cudnn/fx3eyes/hardware/XP/BOM/XPCAM 1V1 PCB BOM.xls

电子产品零件表
 |  | 版本:XPCAM 1V1 PCB BOM V1.0
序号 | 物料代码 | 数量 | 元件位置 | 规格 | 用途 | 备注
1 | 4.2.03.0089 | 3 | C16,C17,C18 | 贴片电容 10nF/0402/50V/10% | PCB
2 | 4.2.03.0088 | 14 | C2,C3,C4,C7,C8, C11,C12,C15,C19,C20, C21,C25,C26,C36 | 贴片电容 0.1uF/0402/16V/10% | PCB
3 | 4.2.03.0096 | 7 | C5,C9,C13,C23,C27, C34,C42 | 贴片电容 1uF/0402/6.3V/10% | PCB
4 | 4.2.03.0095 | 4 | C6,C10,C14,C45 | 贴片电容 4.7uF/0402/6.3V/20% | PCB
5 | 4.2.03.0101 | 7 | C1,C24,C28,C31,C35, C43,C44 | 贴片电容 10uF/0805/25V/10% | PCB
6 | 4.2.02.0205 | 1 | R7 | 贴片电阻 0R/0402/1% | PCB
7 | 4.2.02.0220 | 1 | R3 | 贴片电阻 22R/0402/5% | PCB
8 | 4.2.02.0214 | 5 | R1,R2,R4,R5,R6 | 贴片电阻 10K/0402/1% | PCB
9 | 7.2.01.0411 | 3 | U2,U3,U4 | 降压芯片 TPS73533DRVR | PCB
10 | 7.2.01.0412 | 1 | U1 | 集成芯片 MT9V024IA7XTM | PCB
11 | 7.2.07.0382 | 1 | J1 | 接插端子 20525-030E-02 | PCB
12 | 7.2.06.0203 | 1 |  | PCB光板 | PCB
