cudnn/fx3eyes/hardware/XP2/BOM/XPCAM_1V4 PCB BOM.xls

Sheet: Read me
删除R38,C65更改为4.2.03.0095

Sheet: 170504
电子产品零件表
 |  | 版本:XPCAM 1V4 PCB BOM V1.0
序号 | 物料代码 | 数量 | 元件位置 | 元件描述 | 用途 | 备注
1 | 4.2.03.0104 | 1 | C85 | 贴片电容 1nF/0402/50V/10% | PCB
2 | 4.2.03.0089 | 2 | C81,C84 | 贴片电容 10nF/0402/50V/10% | PCB
3 | 4.2.03.0088 | 10 | C46,C47,C48,C61,C62, C66,C77,C78,C82,C83 | 贴片电容 0.1uF/0402/16V/10% | PCB
4 | 4.2.03.0095 | 7 | C44,C52,C63,C65,C70,C76, C79 | 贴片电容 4.7uF/0402/6.3V/20% | PCB
5 | 4.2.03.0101 | 4 | C39,C45,C64,C71 | 贴片电容 10uF/0805/25V/10% | PCB
6 | 4.2.02.0220 | 1 | R24 | 贴片电阻 22R/0402/5% | PCB
7 | 4.2.02.0214 | 5 | R23,R39,R40,R41,R42 | 贴片电阻 10K/0402/1% | PCB
8 | 7.2.04.0005 | 1 | L1 | 贴片电感 10uH/0805/10% | PCB
9 | 7.2.01.0411 | 1 | U5 | 降压芯片 TPS73533DRVR | PCB
10 | 7.2.01.0412 | 1 | U1 | 集成芯片 MT9V024IA7XTM | PCB
11 | 7.2.07.0382 | 1 | J1 | 接插端子 20525-030E-02 | PCB
12 | 7.2.06.0224 | 1 |  | PCB光板 | PCB
