cudnn/fx3eyes/hardware/XP2/BOM/XPIAC_1V3 PCB BOM.xls

Sheet: Read me
更改说明

Sheet: 171017
电子产品零件表
 |  | 版本:XPIAC 1V3 PCB BOM V1.0
料号 | 物料代码 | 数量 | 元件位置 | 元件描述 | 用途 | 备注
1 | 4.2.03.0104 | 1 | C85 | 贴片电容 1nF/0402/50V/10% | PCB
2 | 7.2.03.0153 | 2 | C49,C50 | 贴片电容 12pF/0402/50V/5% | PCB
3 | 4.2.03.0089 | 10 | C13,C16,C17,C22,C27, C81,C94,C95,C97,C98 | 贴片电容 10nF/0402/50V/10% | PCB
4 | 4.2.03.0088 | 40 | C1,C3,C4,C5,C6,C7, C8,C9,C10,C11,C12, C14,C15,C19,C21,C23, C24,C26,C29,C31,C33, C35,C37,C40,C41,C42, C46,C48,C51,C53,C58, C59,C61,C66,C68,C69, C77,C78,C82,C86 | 贴片电容 0.1uF/0402/16V/10% | PCB
5 | 7.2.03.0146 | 1 | C57 | 贴片电容 0.47uF/0402/6.3V/10% | PCB
6 | 4.2.03.0095 | 13 | C25,C28,C36,C44,C52, C54,C55,C56,C60,C63, C70,C76,C79 | 贴片电容 4.7uF/0402/6.3V/20% | PCB
7 | 4.2.03.0101 | 6 | C32,C34,C39,C43,C45, C64 | 贴片电容 10uF/0805/25V/10% | PCB
8 | 4.2.03.0094 | 4 | C2,C18,C20,C30 | 贴片电容 47uF/0805/6.3V/20% | PCB
9 | 7.2.04.0086 | 1 | L2 | 贴片电感 100uH/600mA | PCB
10 | 7.2.04.0005 | 1 | L1 | 贴片电感 10uH/0805 | PCB
11 | 4.2.02.0205 | 2 | R30,R57 | 贴片电阻 0R/0402/1% | PCB
12 | 4.2.02.0220 | 4 | R22,R24,R27,R60 | 贴片电阻 22R/0402/5% | PCB
13 | 4.2.02.0208 | 2 | R6,R21 | 贴片电阻 200R/0402/1% | PCB
14 | 4.2.02.0218 | 7 | R5,R14,R58,R59,R62, R63,R67 | 贴片电阻 1K/0402/1% | PCB
15 | 4.2.02.0209 | 1 | R18 | 贴片电阻 1.5K/0402/1% | PCB
16 | 4.2.02.0226 | 2 | R25,R26 | 贴片电阻 2.0K/0402/5% | PCB
17 | 4.2.02.0210 | 1 | R20 | 贴片电阻 6.04K/0402/1% | PCB
18 | 4.2.02.0217 | 12 | R1,R2,R3,R11,R12, R15,R16,R17,R19,R29, R31,R32 | 贴片电阻 4.7K/0402/1% | PCB
19 | 4.2.02.0214 | 7 | R9,R23,R39,R40,R41, R42,R44 | 贴片电阻 10K/0402/1% | PCB
20 | 4.2.02.0213 | 1 | R53 | 贴片电阻 28K/0402/1% | PCB
21 | 4.2.02.0233 | 3 | R4,R13,R56 | 贴片电阻 100K/0402/1% | PCB
22 | 7.2.05.0130 | 1 | LED1 | 发光二极管 红色/0805 | PCB
23 | 4.2.04.0507 | 3 | FB1,FB2,FB3 | 磁珠 600@100MHz | PCB
24 | 7.2.08.0222 | 1 | Y2 | 27M晶振 XTAL-3225 | PCB
25 | 7.2.08.0223 | 1 | U7 | 32.768K晶振 XTAL-3225 | PCB
26 | 7.2.08.0224 | 1 | Y1 | 19.2M晶振 XTAL_3225 | PCB
27 | 7.2.01.0413 | 1 | U9 | 陀螺仪芯片 ICM-20608-G | PCB
28 | 7.2.01.0414 | 1 | U13 | 降压芯片 AS1364-BTDT-AD | PCB
29 | 7.2.05.1005 | 4 | Q1,Q2,Q3,Q4 | NPN三极管 BC817 | PCB
30 | 7.2.08.0139 | 2 | S1,S2 | 贴片按键 2P | PCB
31 | 7.2.08.0049 | 1 | U6 | 贴片保险丝 SP3010-04UTG | PCB
32 | 7.2.01.0415 | 1 | U4 | 降压芯片 TPS74801DRCR | PCB
33 | 7.2.01.0416 | 1 | U2 | EEPROM芯片 M25P40-VMN3TPB | PCB
34 | 7.2.01.0417 | 1 | U1 | USB控制器 CYUSB3014 | PCB
35 | 7.2.07.1076 | 1 | J1 | USB3.0插头USB3_MICROB | PCB
36 | 7.2.07.0192 | 1 | P1 | uart接插端子 A1252MV-04P | PCB
37 | 7.2.07.0382 | 1 | J6 | 接插端子 20525-030E-02C | PCB
38 | 7.2.01.0411 | 1 | U5 | 降压芯片 TPS73533DRVR | PCB
39 | 7.2.01.0412 | 1 | U8 | 集成芯片 MT9V024IA7XTM | PCB
40 | 7.2.06.0236 | 1 |  | PCB光板 | PCB
