cudnn/fx3eyes/hardware/XP/schematic&PCB PDF/schematic/XPIMU_1V1_SCH.pdf

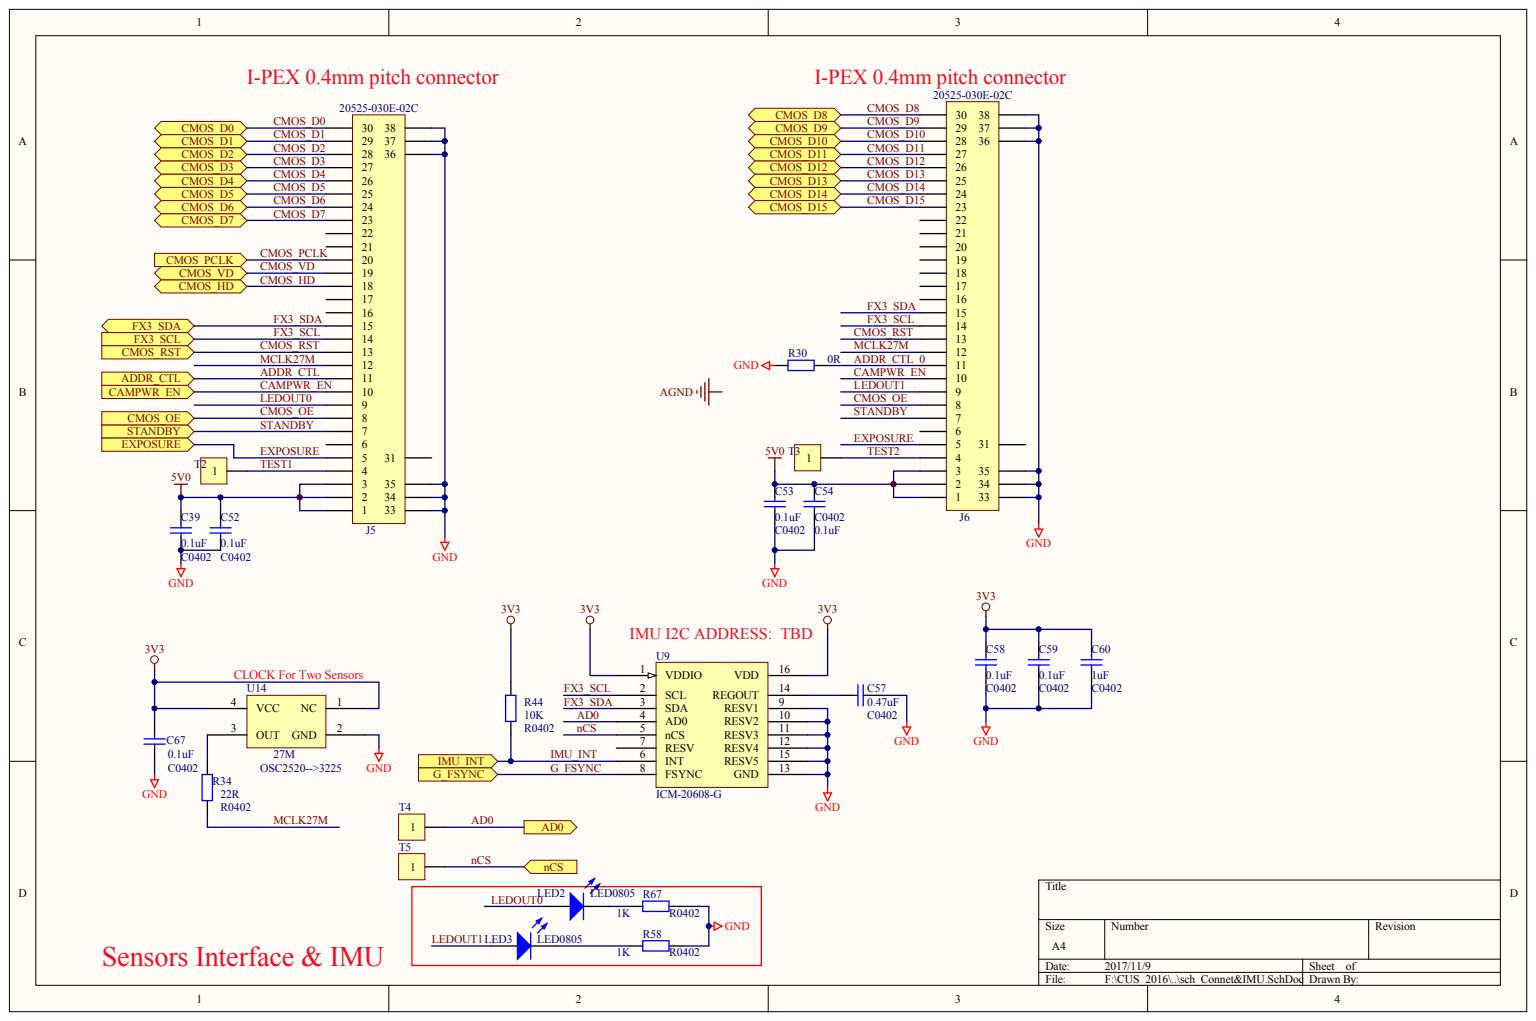
[picture p1: page 1]

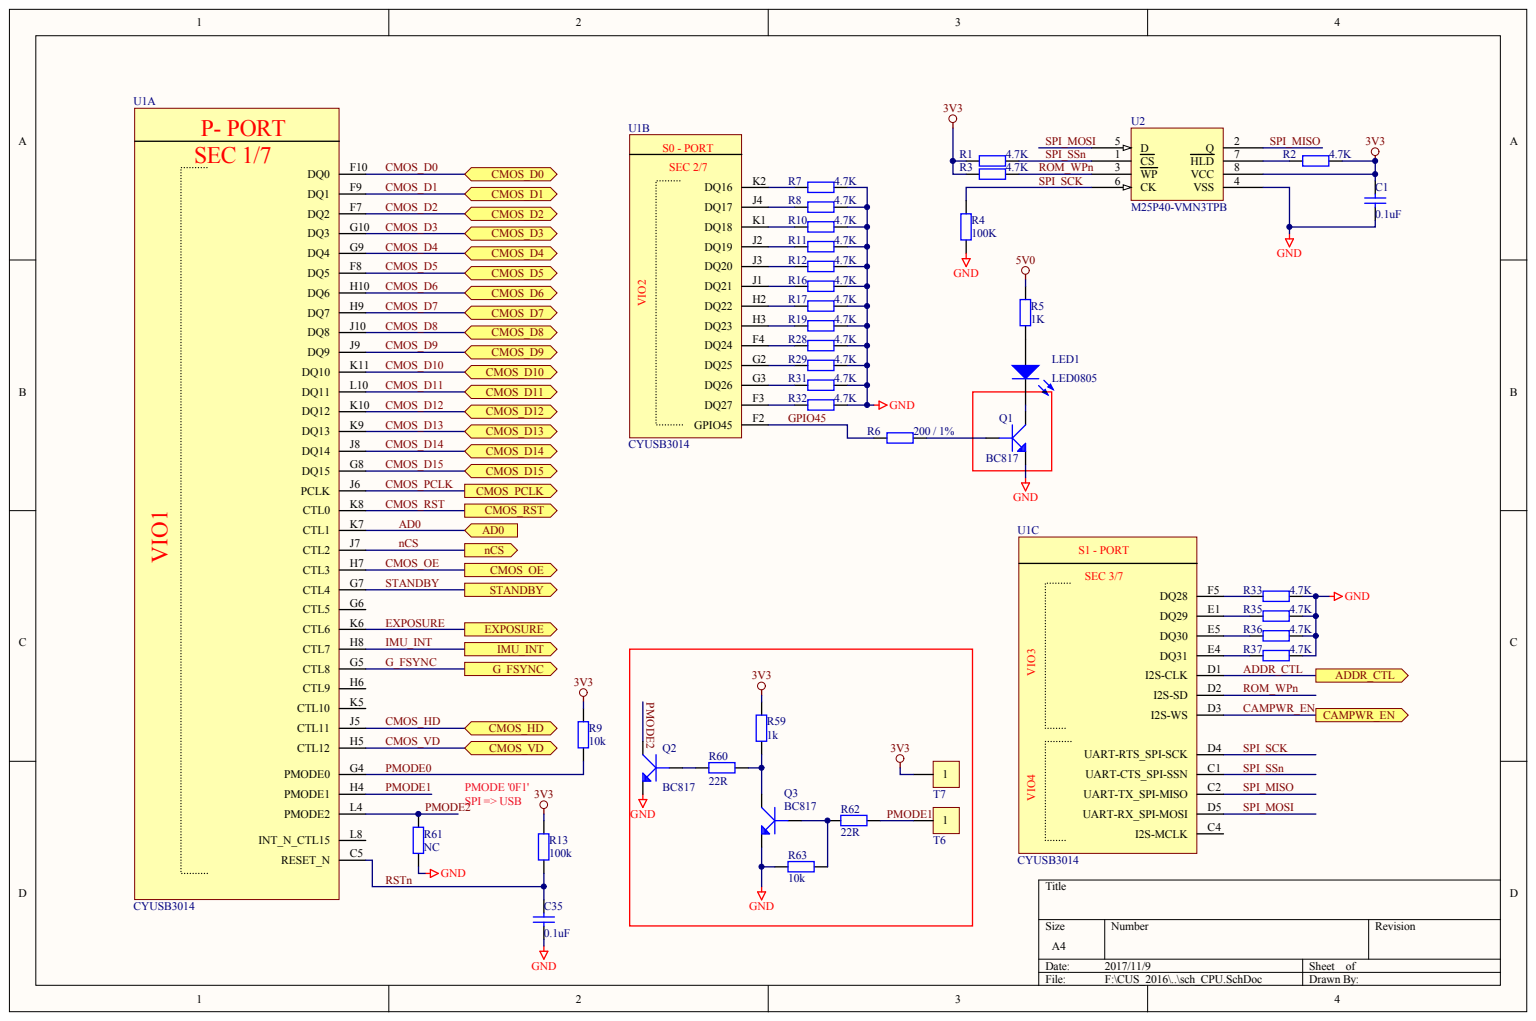
[picture p2: page 2]

SEC 2/ | 7

R3 | 4.7 K ROM _WPn 3

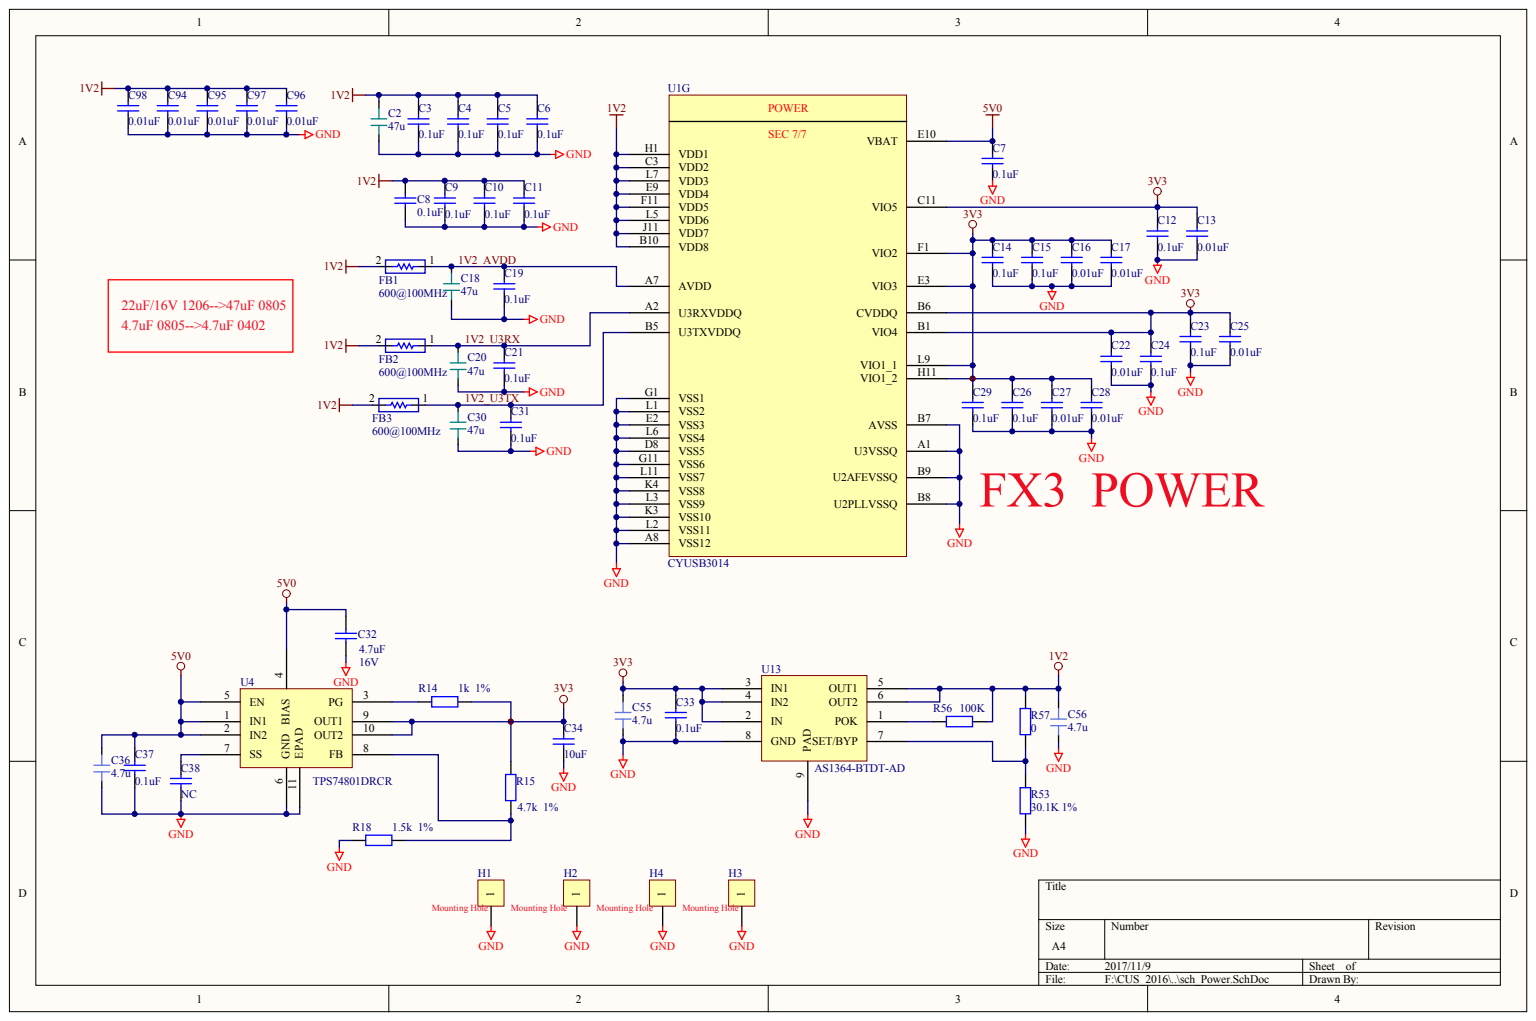
[picture p3: page 3]

VDD3 L7

VDD5 F11
VDD6 L5
VDD7 J11

U3RXVDDQ A2
U3TXVDDQ B5

VSS2 L1
VSS3 E2
VSS4 L6
VSS5 D8
VSS6 G11
VSS7 L11
VSS8 K4
VSS9 L3
VSS10 K3
VSS11 L2

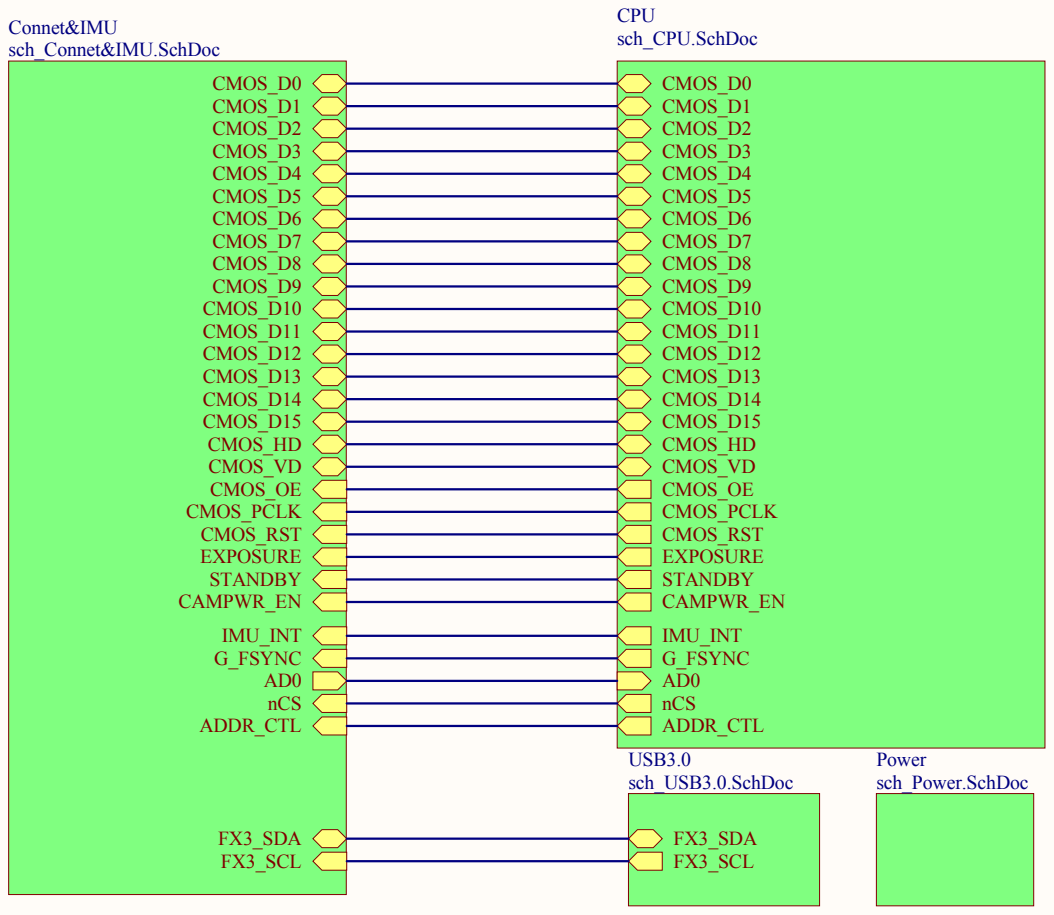
[picture p4: page 4]

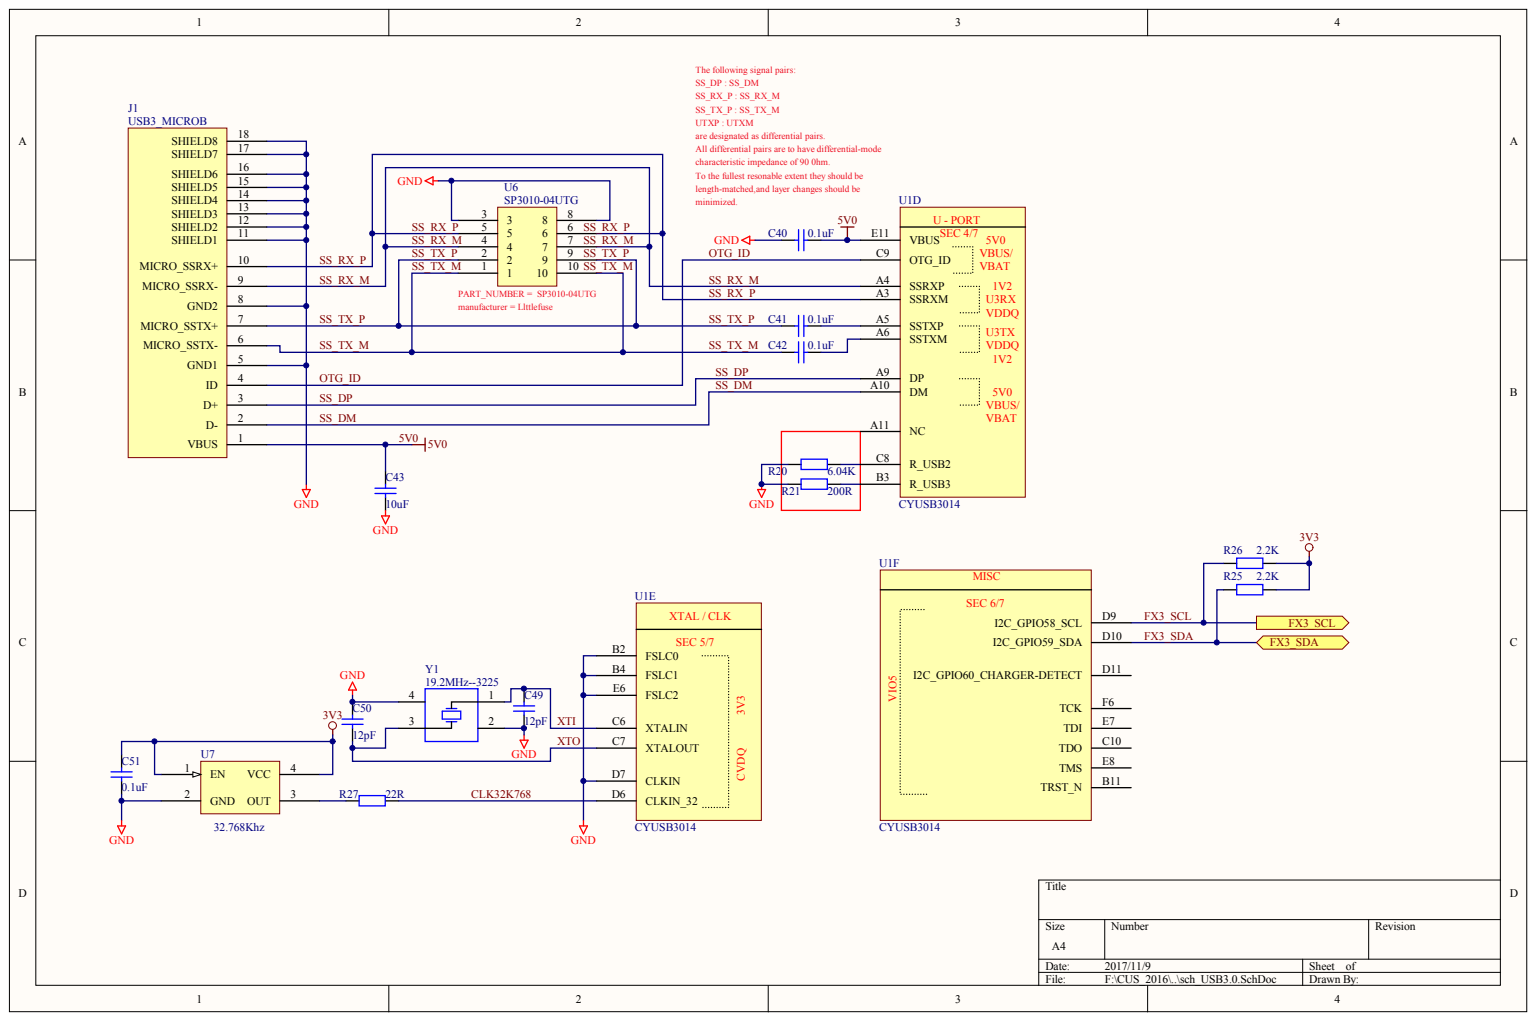
[picture p5: page 5]

The following signal pairs:
UTXP : UTXM
are designated as differential pairs.
All differential pairs are to have differential-mode
characteristic impedance of 90 0hm.
To the fullest resonable extent they should be
length-matched,and layer changes should be
minimized.

SS_RX_M | 4 4 | SS_RX_M
SS_TX_P | 1 1 2 2 | SS_TX_P
SS_TX_M | SS_TX_M | SS_RX_M | SSRXM A3 SSRXP A4

SS_DP | | NC A11
SS_DM

R_USB2 C8

R20 | 6.04K | R_USB3 B3

SEC 6/7

FSLC1 B4
FSLC2 E6

XTALIN C6

12pF | | XTALOUT C7

GND

CLKIN_32 D6

Comment | Description | Designator | Footprint | LibRef | Quantity
0.1uF | Capacitor | C1, C3, C4, C5, C6, C7, C8, C9, C10, C11, C12, C14, C15, C19, C21, C23, C24, C26, C29, C31, C33, C35, C37, C39, C40, C41, C42, C51, C52, C53, C54, C58, C59, C67 | 0402C | Cap | 34
47u | CC08052B476M5B 20D | C2, C18, C20, C30 | 0805C | cap0805 | 4
0.01uF | Capacitor | C13, C16, C17, C22, C25, C27, C28, C94, C95, C96, C97, C98 | 0402C | Cap | 12
4.7uF | Capacitor | C32 | 0805C | Cap | 1
10uF | Capacitor | C34, C43 | 0805C | Cap | 2
4.7u | CC0402MRX5R5BB 475 | C36, C55, C56 | 0402C | cap0402 | 3
NC | Capacitor | C38 | 0402C | Cap | 1
12pF | Capacitor | C49, C50 | 0402C | Cap | 2
0.47uF | Capacitor | C57 | 0402C | Cap | 1
1uF | Capacitor | C60 | 0402C | Cap | 1
600@100MHz | | FB1, FB2, FB3 | 0402R | 600@100MHz | 3
CON1 | Connector | H1, H2, H3, H4 | PAD_M3_D350_45 0 | CON1 | 4
USB3_MICROB | | J1 | USB3_BA_P65L13 0W51H28 | USB3_MICROB | 1
20525-030E-02C | | J5, J6 | HSA30_P40L196W 42H10_20525 | 20525-030E-02C | 2
LED0805 | 发光二级管 | LED1, LED2, LED3 | LED0805A_L210W 100H60 | LED | 3
BC817 | NPN Transistor | Q1, Q2, Q3 | SOT-23L | NPN | 3
4.7K | Resistor | R1, R2, R3, R7, R8, R10, R11, R12, R16, R17, R19, R28, R29, R31, R32, R33, R35, R36, R37 | 0402R | Resistor | 19
100K | Resistor | R4, R13, R56 | 0402R | Resistor | 3
1K | Resistor | R5, R14, R58, R59, R67 | 0402R | Res2, Resistor | 5
200R | Resistor | R6, R21 | 0402R | Resistor | 2
10K | Resistor | R9, R44, R63 | 0402R | Res2, Resistor | 3
51K | Resistor | R15 | 0402R | Resistor | 1
1.15K | Resistor | R18 | 0402R | Resistor | 1
6.04K | Resistor | R20 | 0402R | Resistor | 1
2.2K | Resistor | R25, R26 | 0402R | Resistor | 2
22R | Resistor | R27, R34, R60, R62 | 0402R | Res2, Resistor | 4
0R | Resistor | R30, R57 | 0402R | Res2, Resistor | 2
30.1K | Resistor | R53 | 0402R | Resistor | 1
NC | Resistor | R61 | 0805R | Resistor | 1
CON1 | Connector | T2, T3, T4, T5, T6, T7 | PAD_TP_D1.2 | CON1 | 6
CYUSB3014 | | U1 | FBGA121_P80L100 W100H11 | CYUSB3014 | 1
M25P40-VMN3TPB | | U2 | SO8N_P127L50W4 0W62H17 | M25P40-VMN3TPB | 1
TPS74801DRCR | | U4 | SON10_P50L32W3 2H10_DRC | TPS74801DRCR | 1
SP3010-04UTG | | U6 | UDFN10_SON_P50 L25W10H55 | SP3010-04UTG | 1
XTAL-3225 | | U7 | XTAL_3225 | XTAL. | 1
ICM-20608-G | | U9 | LGA16_P50L30W3 0H08 | ICM-20608-G | 1
AS1364-BTDT-AD | | U13 | TDFN8_P65L30W3 0H08 | AS1364-BTDT-AD | 1
OSC2520-->3225 | Simple Package Xtal Oscillator | U14 | XTAL_3225 | XTAL-SPXO | 1
19.2MHz--3225 | Crystal Oscillator | Y1 | XTAL_3225 | XTAL | 1
