cudnn/fx3eyes/hardware/XP/schematic&PCB PDF/PCB/XPCAM_1V1..pdf

# H1H¹x1

# H3H³x1

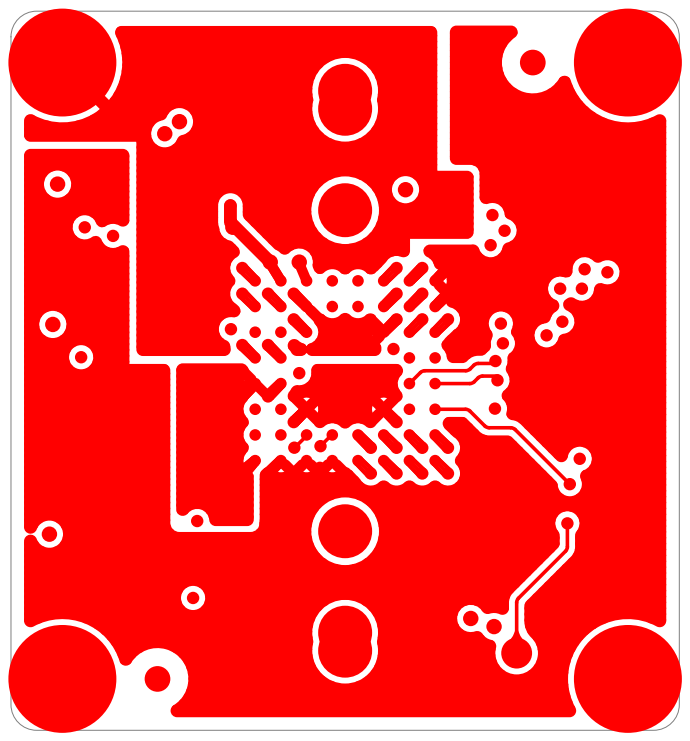
[picture p14: page 1]
U1U¹xA¹ U¹xA² U¹xA³ U¹xA⁴ U¹xA⁵ U¹xA⁶ U¹xA⁷ U¹xA⁸; U¹xB¹ U¹xB² U¹xB³ U¹xB⁴ U¹xB⁵ U¹xB⁶ U¹xB⁷ U¹xB⁸; U¹xC¹ U¹xC² U¹xC³ U¹xC⁶ U¹xC⁷ U¹xC⁸; U¹xD¹ U¹xD² U¹xD⁷ U¹xD⁸; U¹xE¹ U¹xE² U¹xE⁷ U¹xE⁸; U¹xF1 U¹xF2 U¹xF3 U¹xF6 U¹xF7 U¹xF8; U¹xG¹ U¹xG² U¹xG³ U¹xG⁴ U¹xG⁵ U¹xG⁶ U¹xG⁷ U¹xG⁸; U¹xH¹ U¹xH² U¹xH³ U¹xH⁴ U¹xH⁵ U¹xH⁶ U¹xH⁷ U¹xH⁸; H2H²x1; H4H⁴x1; LM1LM¹x1; LM2LM²x1; M1M¹x1; M2M²x1; LM3LM³x1; LM4LM⁴x1

# H1H¹x1

# H3H³x1

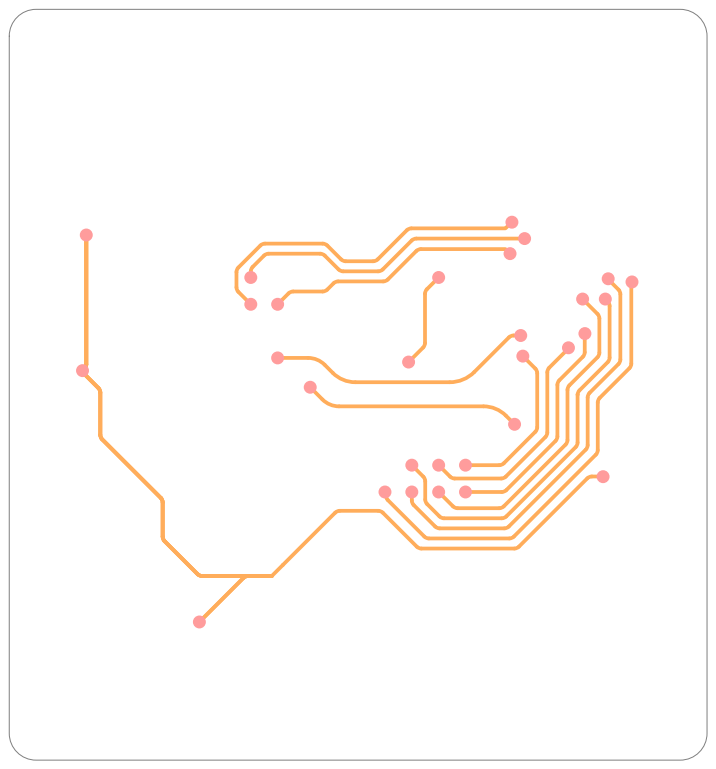
[picture p15: page 2]
H2H²x1; H4H⁴x1; LM1LM¹x1; LM2LM²x1; LM3LM³x1; LM4LM⁴x1

# H1H¹x1

# H3H³x1

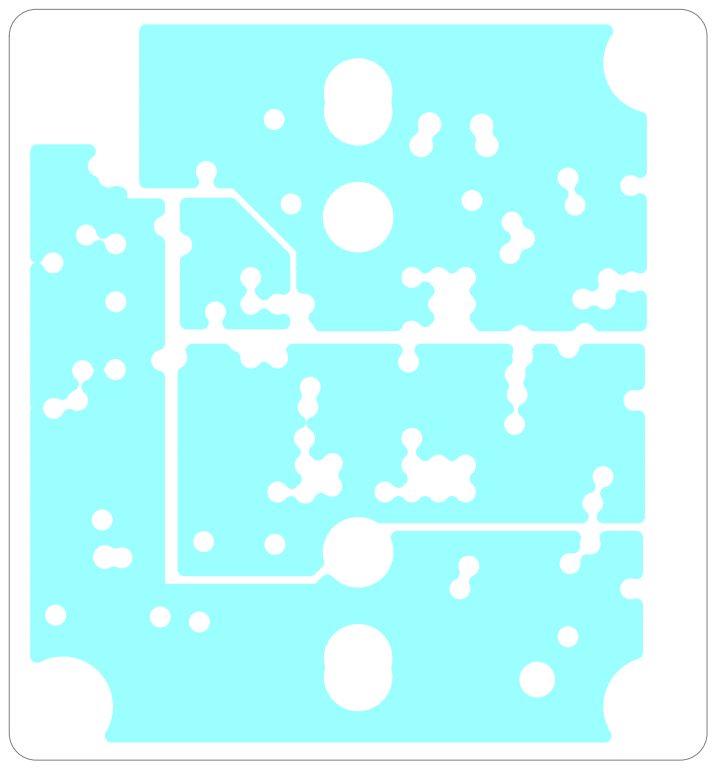
[picture p16: page 3]
H2H²x1; H4H⁴x1; LM1LM¹x1; LM2LM²x1; LM3LM³x1; LM4LM⁴x1

# C28 C²⁸x2 C²⁸x1

# H1H¹x1

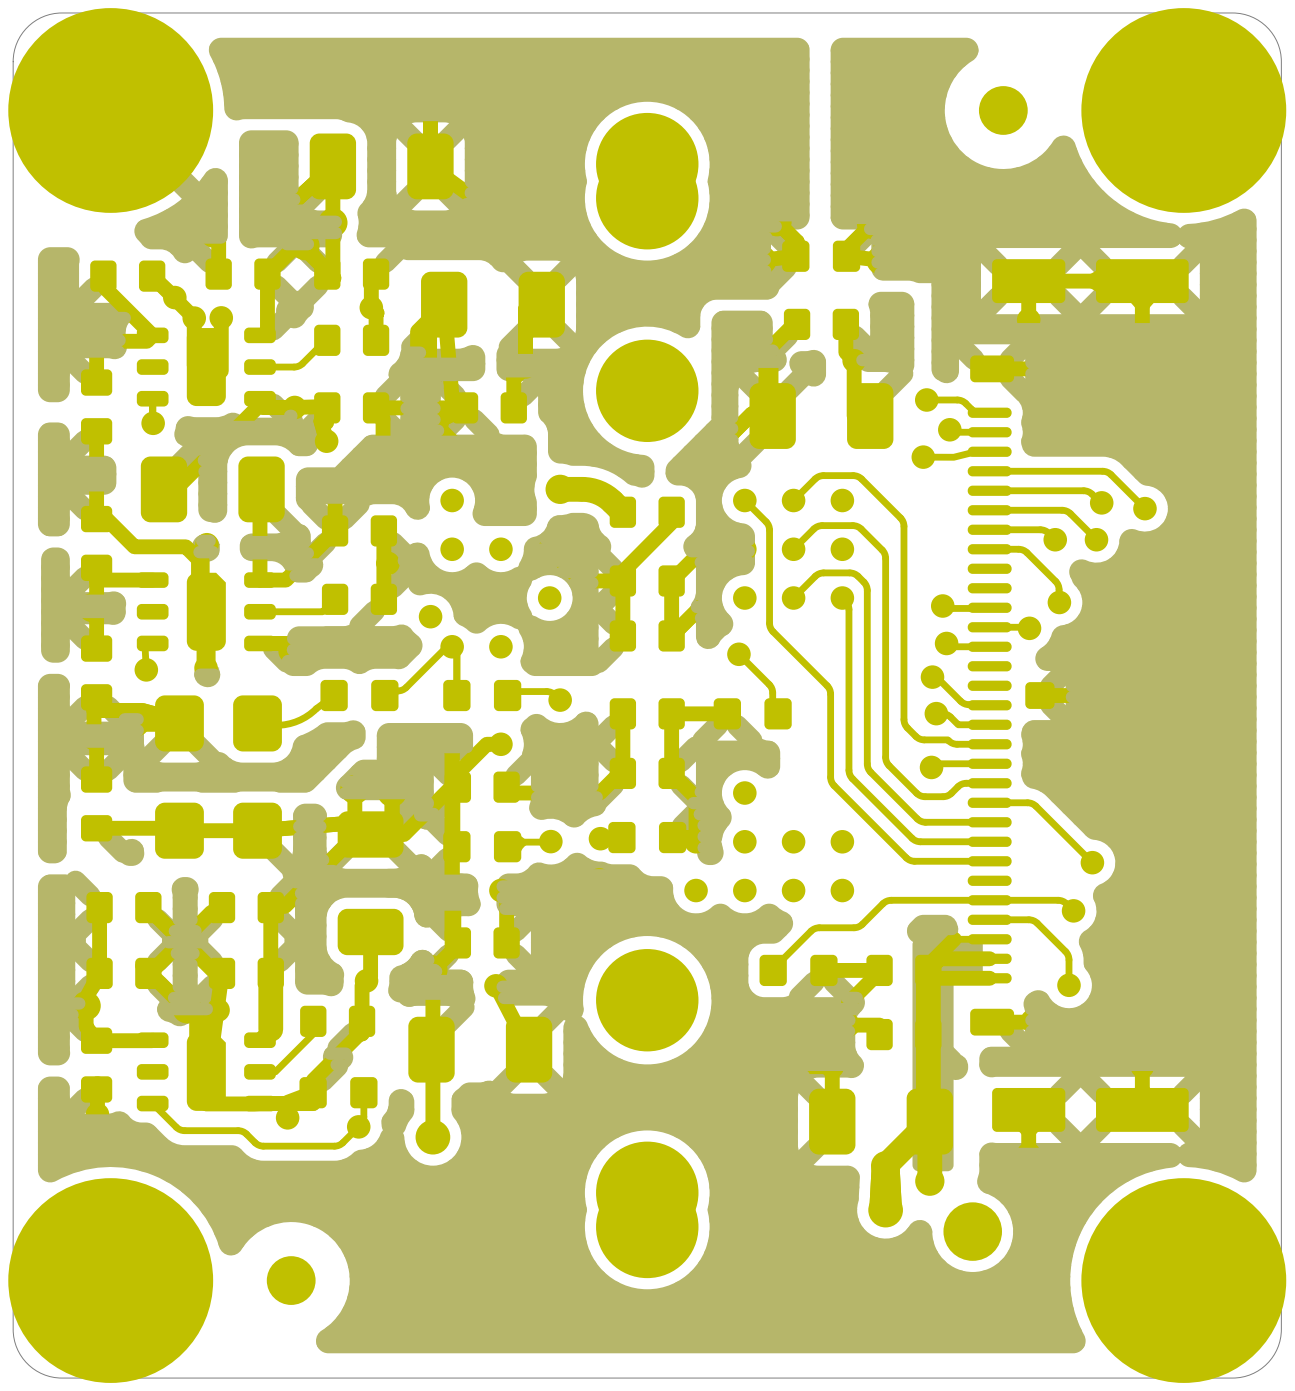
[picture p17: page 4]

# H1H¹x1

# H3H³x1

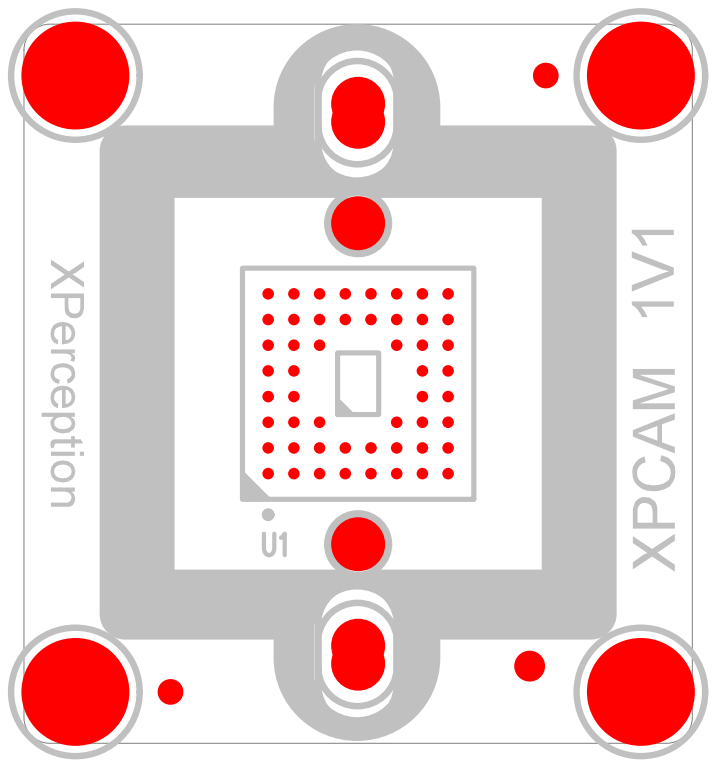
[picture p18: page 5]
XPCAM 1V1; XPerception; H2H²x1; H4H⁴x1; LM1LM¹x1; LM2LM²x1; M1M¹x1; M2M²x1; LM3LM³x1; LM4LM⁴x1

U1U¹xA¹ U¹xA² U¹xA³ U¹xA⁴ U¹xA⁵ U¹xA⁶ U¹xA⁷ U¹xA⁸

C28

J1

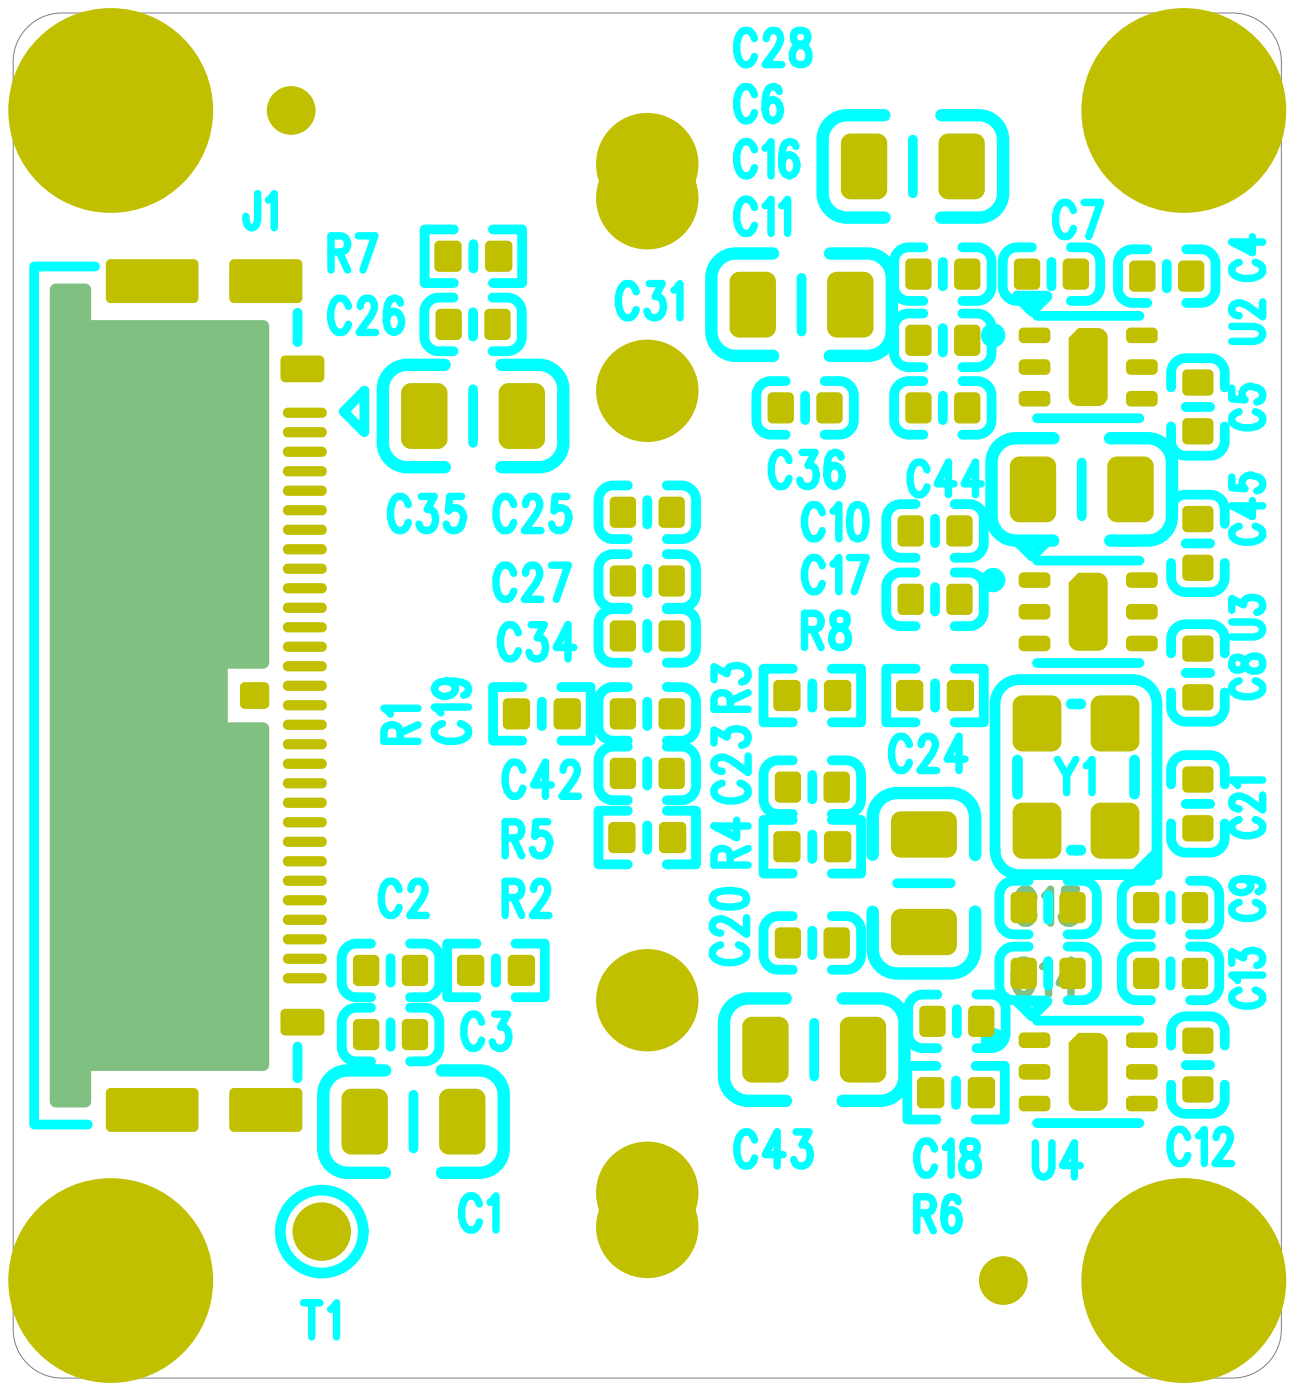
[picture p19: page 6]
