cudnn/fx3eyes/hardware/XP2/schematic&PCB PDF/PCB/XPCAM_1V4.pdf

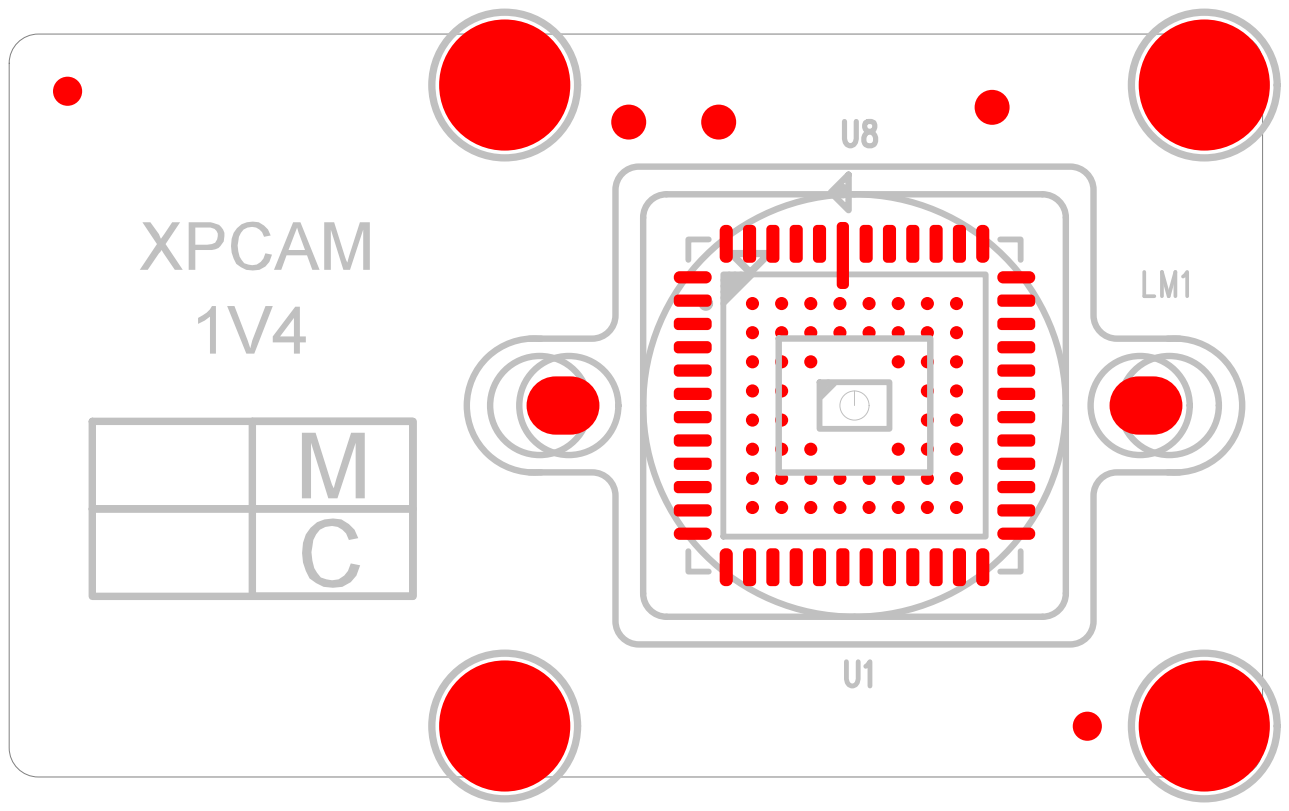
[picture p20: page 1]
XPCAM; LM1 LM1 U8U1 LM¹x1; LM¹x2 U¹xA¹; U¹xA²; U¹xA³; U¹xA⁴; U¹xA⁵; U¹xA⁶; U¹xA⁷; U¹xA⁸ U¹xB¹; U¹xB²; U¹xB³; U¹xB⁴; U¹xB⁵; U¹xB⁶; U¹xB⁷; U¹xB⁸ U¹xC¹; U¹xC²; U¹xC³; U¹xC⁶; U¹xC⁷; U¹xC⁸ U¹xD¹; U¹xD²; U¹xD⁷; U¹xD⁸ U¹xE¹; U¹xE²; U¹xE⁷; U¹xE⁸ U¹xF1; U¹xF2; U¹xF3; U¹xF6; U¹xF7; U¹xF8 U¹xG¹; U¹xG²; U¹xG³; U¹xG⁴; U¹xG⁵; U¹xG⁶; U¹xG⁷; U¹xG⁸ U¹xH¹; U¹xH²; U¹xH³; U¹xH⁴; U¹xH⁵; U¹xH⁶; U¹xH⁷; U¹xH⁸; H1H¹x1; H2H²x1; H3H³x1; H4H⁴x1; M1M¹x1; M2M²x1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

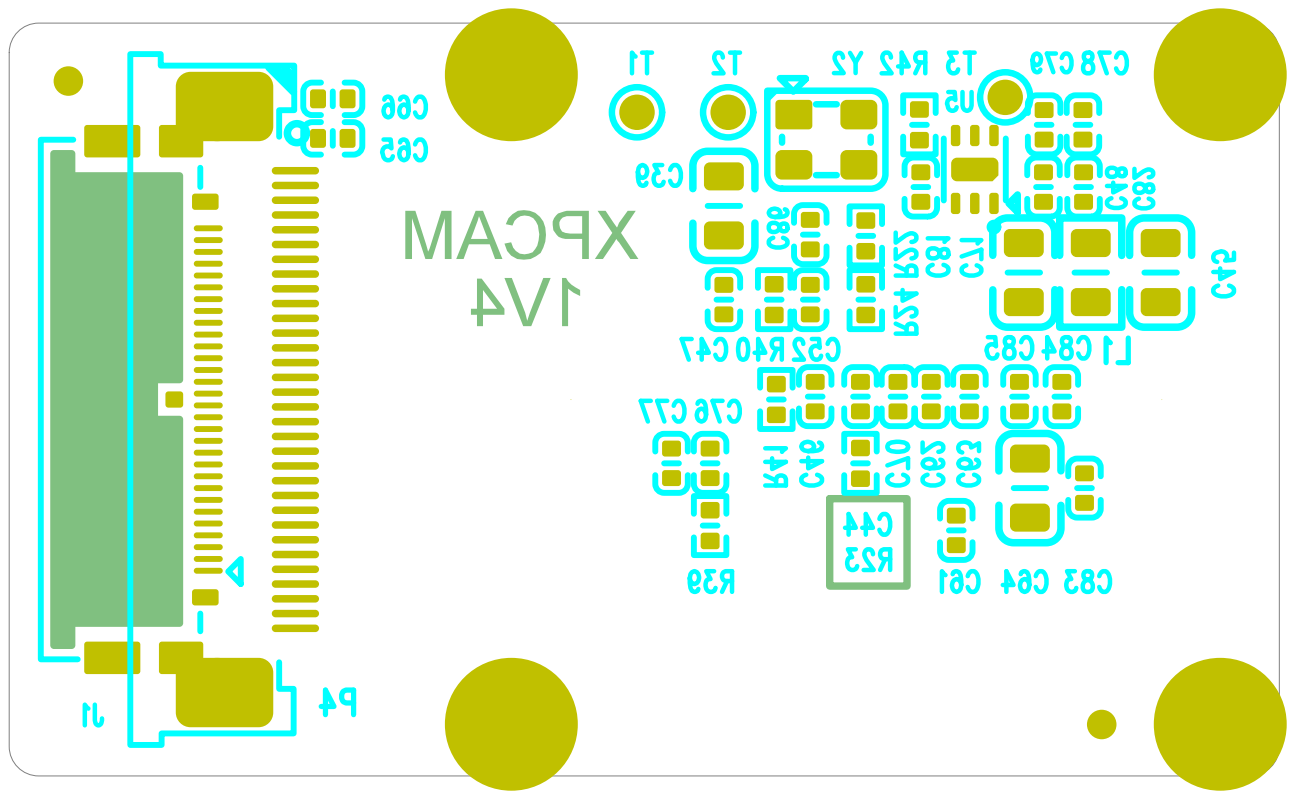
[picture p21: page 2]

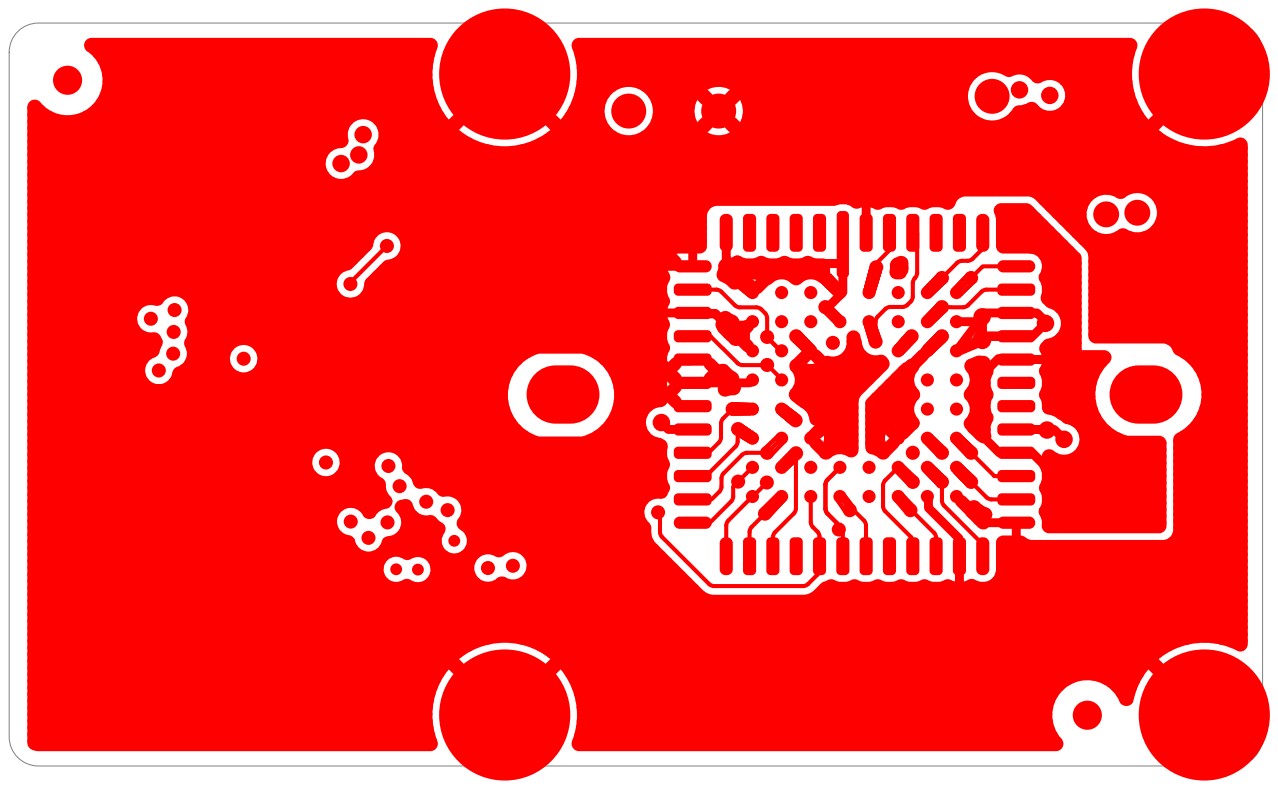
[picture p22: page 3]
LM1 LM¹x1; U1 LM¹x2 U¹xA¹; U¹xA²; U¹xA³; U¹xA⁴; U¹xA⁵; U¹xA⁶; U¹xA⁷; U¹xA⁸ U¹xB¹; U¹xB²; U¹xB³; U¹xB⁴; U¹xB⁵; U¹xB⁶; U¹xB⁷; U¹xB⁸ U¹xC¹; U¹xC²; U¹xC³; U¹xC⁶; U¹xC⁷; U¹xC⁸ U¹xD¹; U¹xD²; U¹xD⁷; U¹xD⁸ U¹xE¹; U¹xE²; U¹xE⁷; U¹xE⁸ U¹xF1; U¹xF2; U¹xF3; U¹xF6; U¹xF7; U¹xF8 U¹xG¹; U¹xG²; U¹xG³; U¹xG⁴; U¹xG⁵; U¹xG⁶; U¹xG⁷; U¹xG⁸ U¹xH¹; U¹xH²; U¹xH³; U¹xH⁴; U¹xH⁵; U¹xH⁶; U¹xH⁷; U¹xH⁸; H1H¹x1; H2H²x1; H3H³x1; H4H⁴x1; M1M¹x1; M2M²x1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

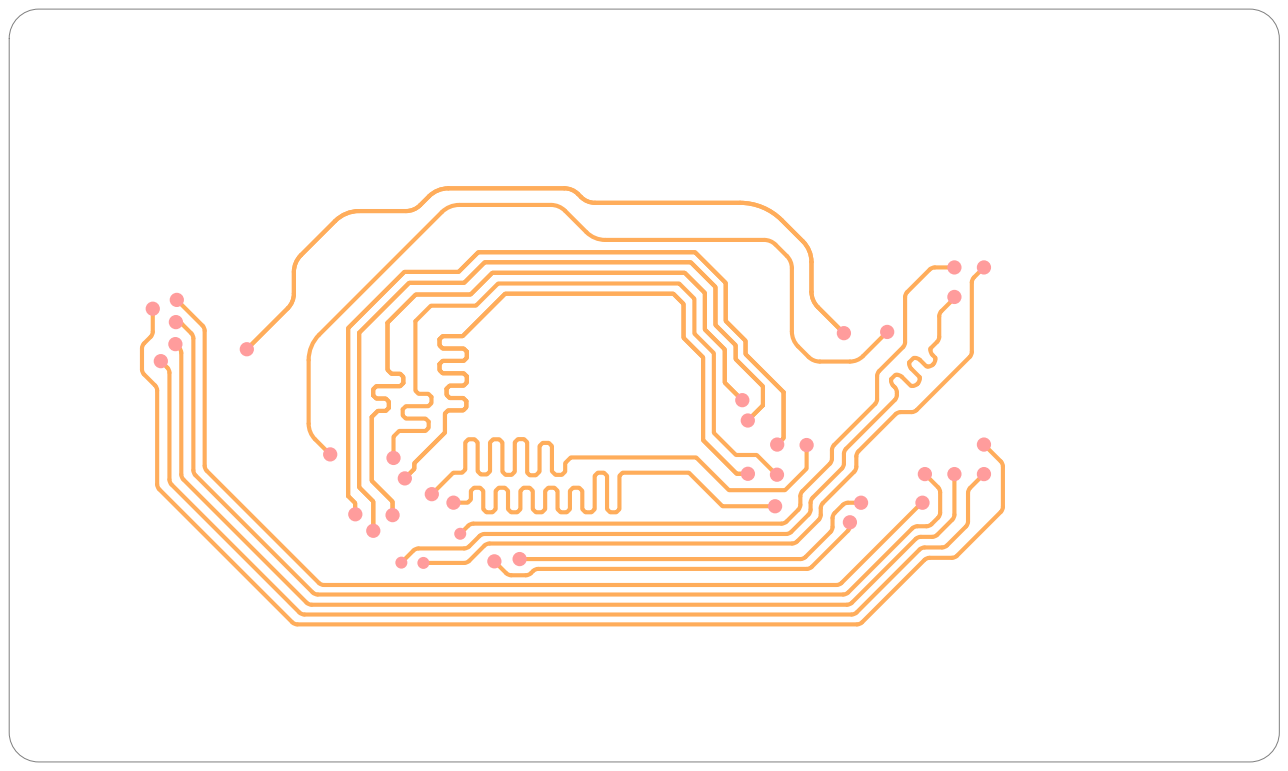
[picture p23: page 4]
H1H¹x1; H2H²x1; H3H³x1; H4H⁴x1

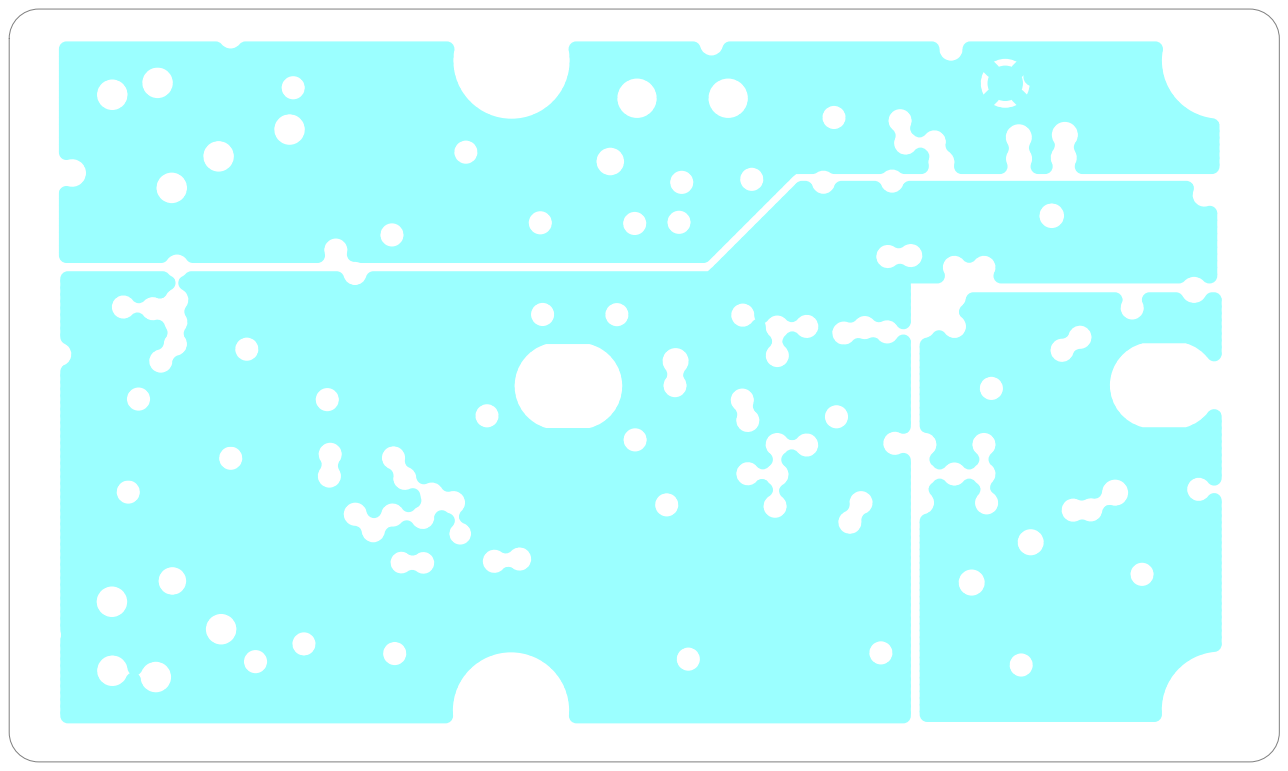
[picture p24: page 5]
H1H¹x1; H2H²x1; H3H³x1; H4H⁴x1

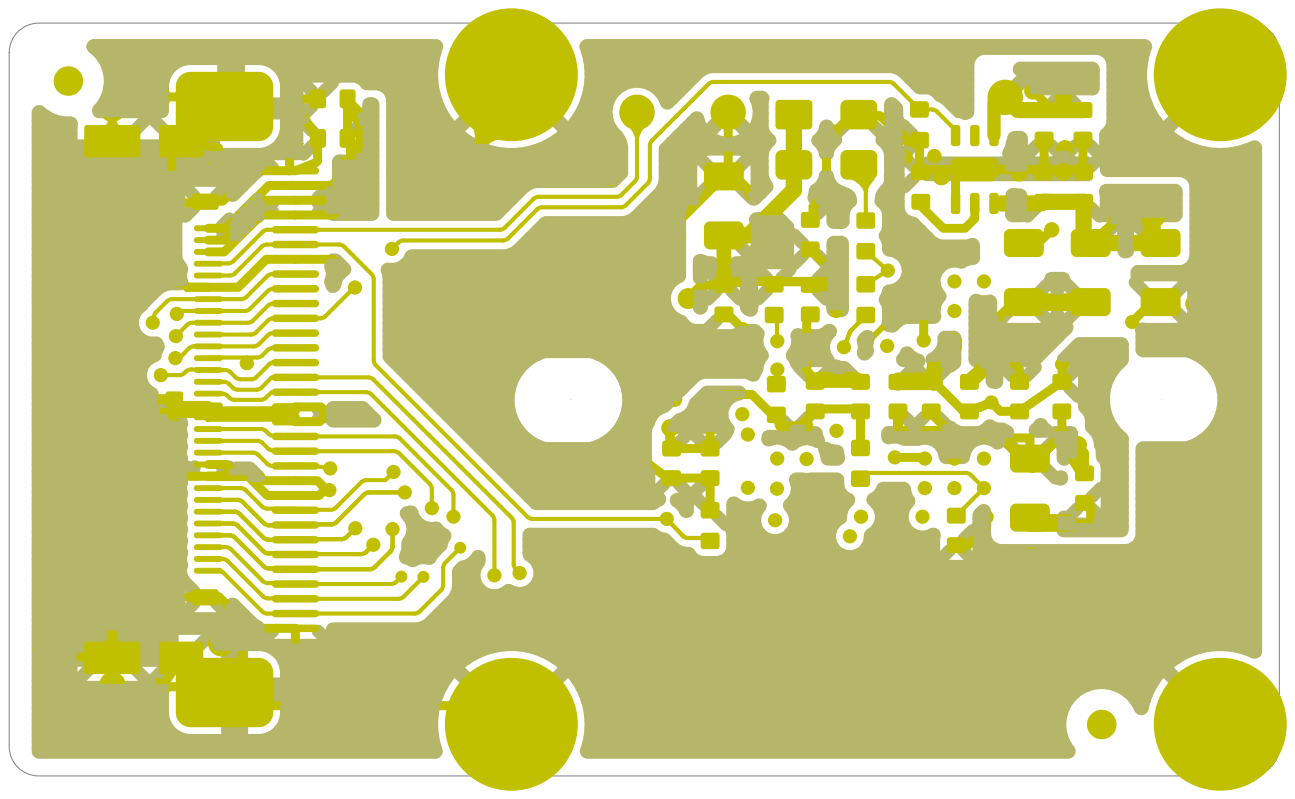
[picture p25: page 6]
C76C⁷⁶x1 C⁷⁶x2; R41R⁴¹x1 R⁴¹x2; R23R²³x1 R²³x2; C70C⁷⁰x1 C⁷⁰x2; C86C⁸⁶x1; R24R²⁴x1 R²⁴x2; C71C⁷¹x1 C⁷¹x2; C83C⁸³x1 C⁸³x2; C82C⁸²x1 C⁸²x2; R42R⁴²x1 R⁴²x2; C81C⁸¹x1 C⁸¹x2; C77C⁷⁷x1 C⁷⁷x2; C79C⁷⁹x1 C⁷⁹x2; C78C⁷⁸x1 C⁷⁸x2; C64C⁶⁴x1 C⁶⁴x2; C45C⁴⁵x1 C⁴⁵x2; H1H¹x1; H2H²x1; H3H³x1; H4H⁴x1; C66 C⁶⁶x1; C⁶⁶x2; C44C⁴⁴x1 C⁴⁴x2; C47C⁴⁷x1 C⁴⁷x2; C52C⁵²x1 C⁵²x2; C63C⁶³x1 C⁶³x2; C62C⁶²x1 C⁶²x2; C84C⁸⁴x1; R39R³⁹x1 R³⁹x2; R40R⁴⁰x1 R⁴⁰x2; C48C⁴⁸x1 C⁴⁸x2; M1M¹x1; M2M²x1; R22R²²x1 R²²x2; C85C⁸⁵x1 C⁸⁵x2; U5U⁵x3; U⁵x2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
