cudnn/fx3eyes/(list of files, drawings)

Other design files:
hardware/XP2/PCB file/DXP/XPCAM_1V4.PCBDOC
hardware/XP2/PCB file/DXP/XPIAC_1V3.PCBDOC
hardware/XP2/PCB file/PADS/XPIAC_1V3.pcb
hardware/XP2/schematic/XPCAM_1V4/sch_Camera.SchDoc
hardware/XP2/schematic/XPCAM_1V4/XPCAM_1V4.PrjPCB
hardware/XP2/schematic/XPIAC_1V3/sch_camera.SchDoc
hardware/XP2/schematic/XPIAC_1V3/sch_Connet&IMU.SchDoc
hardware/XP2/schematic/XPIAC_1V3/sch_CPU.SchDoc
hardware/XP2/schematic/XPIAC_1V3/sch_Power.SchDoc
hardware/XP2/schematic/XPIAC_1V3/sch_Top.SchDoc
hardware/XP2/schematic/XPIAC_1V3/sch_USB3.0.SchDoc
hardware/XP2/schematic/XPIAC_1V3/XPIAC_1V3.PrjPCB
hardware/XP3/PCB file/DXP/XPCAM-C_1V4.PCBDOC
hardware/XP3/PCB file/DXP/XPIAC-C_1V3.PCBDOC
hardware/XP3/PCB file/PADS/XPIAC_1V3.pcb
hardware/XP3/schematic/XPCAM-C_1V4/sch_Camera.SchDoc
hardware/XP3/schematic/XPCAM-C_1V4/XPCAM-C_1V4.PrjPCB
hardware/XP3/schematic/XPIAC-C_1V3/sch_camera.SchDoc
hardware/XP3/schematic/XPIAC-C_1V3/sch_Connet&IMU.SchDoc
hardware/XP3/schematic/XPIAC-C_1V3/sch_CPU.SchDoc
hardware/XP3/schematic/XPIAC-C_1V3/sch_Power.SchDoc
hardware/XP3/schematic/XPIAC-C_1V3/sch_Top.SchDoc
hardware/XP3/schematic/XPIAC-C_1V3/sch_USB3.0.SchDoc
hardware/XP3/schematic/XPIAC-C_1V3/XPIAC-C_1V3.PrjPCB
hardware/XP/PCB file/DXP/XPCAM_1V1.PCBDOC
hardware/XP/PCB file/DXP/XPIMU_1V1.PCBDOC
hardware/XP/PCB file/PADS/XPCAM_1V2.pcb
hardware/XP/PCB file/PADS/XPIMU_1V1.pcb
hardware/XP/schematic/XPCAM_1V1/sch_Camera.SchDoc
hardware/XP/schematic/XPCAM_1V1/XPCAM_1V1.PrjPCB
hardware/XP/schematic/XPIMU_1V1/sch_Connet&IMU.SchDoc
hardware/XP/schematic/XPIMU_1V1/sch_CPU.SchDoc
hardware/XP/schematic/XPIMU_1V1/sch_Power.SchDoc
hardware/XP/schematic/XPIMU_1V1/sch_Top.SchDoc
hardware/XP/schematic/XPIMU_1V1/sch_USB3.0.SchDoc
hardware/XP/schematic/XPIMU_1V1/XPIMU_1V1.PrjPCB
