cudnn/fx3eyes/firmware/include/xp_sensor_firmware_version.h

#ifndef __XP_SENSOR_FIRMWARE_VERSION_H__
#define __XP_SENSOR_FIRMWARE_VERSION_H__

#define FIRMWARE_VERSION "V0.3.9--commit"

#define COMPILE_BY "rangj"
#define COMPILE_HOST "rangj-YangTxw"
#define COMPILE_TIME "15:50:02"
#define COMPILE_DATE "2017-11-20"

#endif
